soggybag/Loop-Echo/docs/small_time_reference.jpg

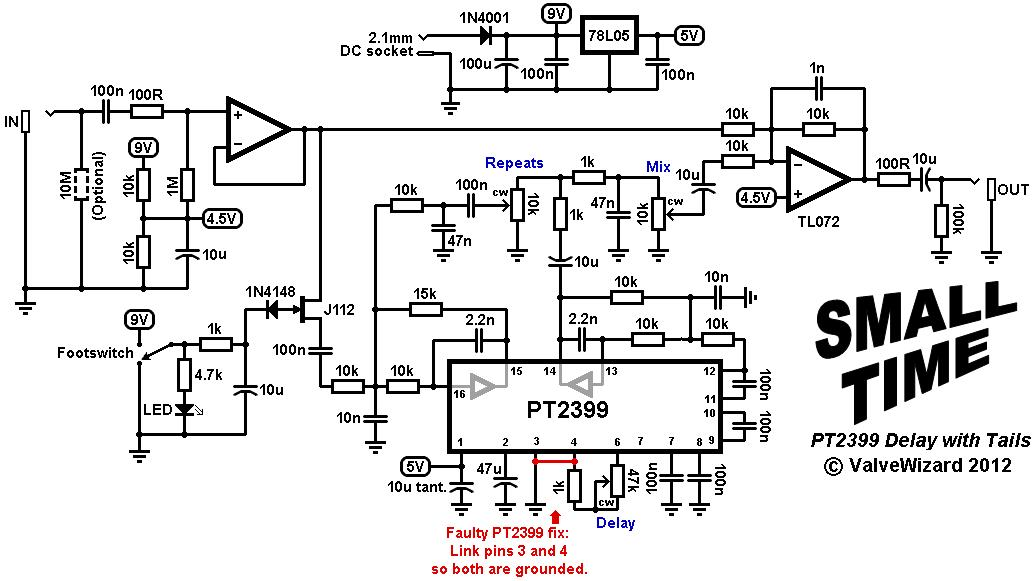
docs/small_time_reference.jpg
