soggybag/Loop-Echo/docs/LoopEcho_schematic.pdf

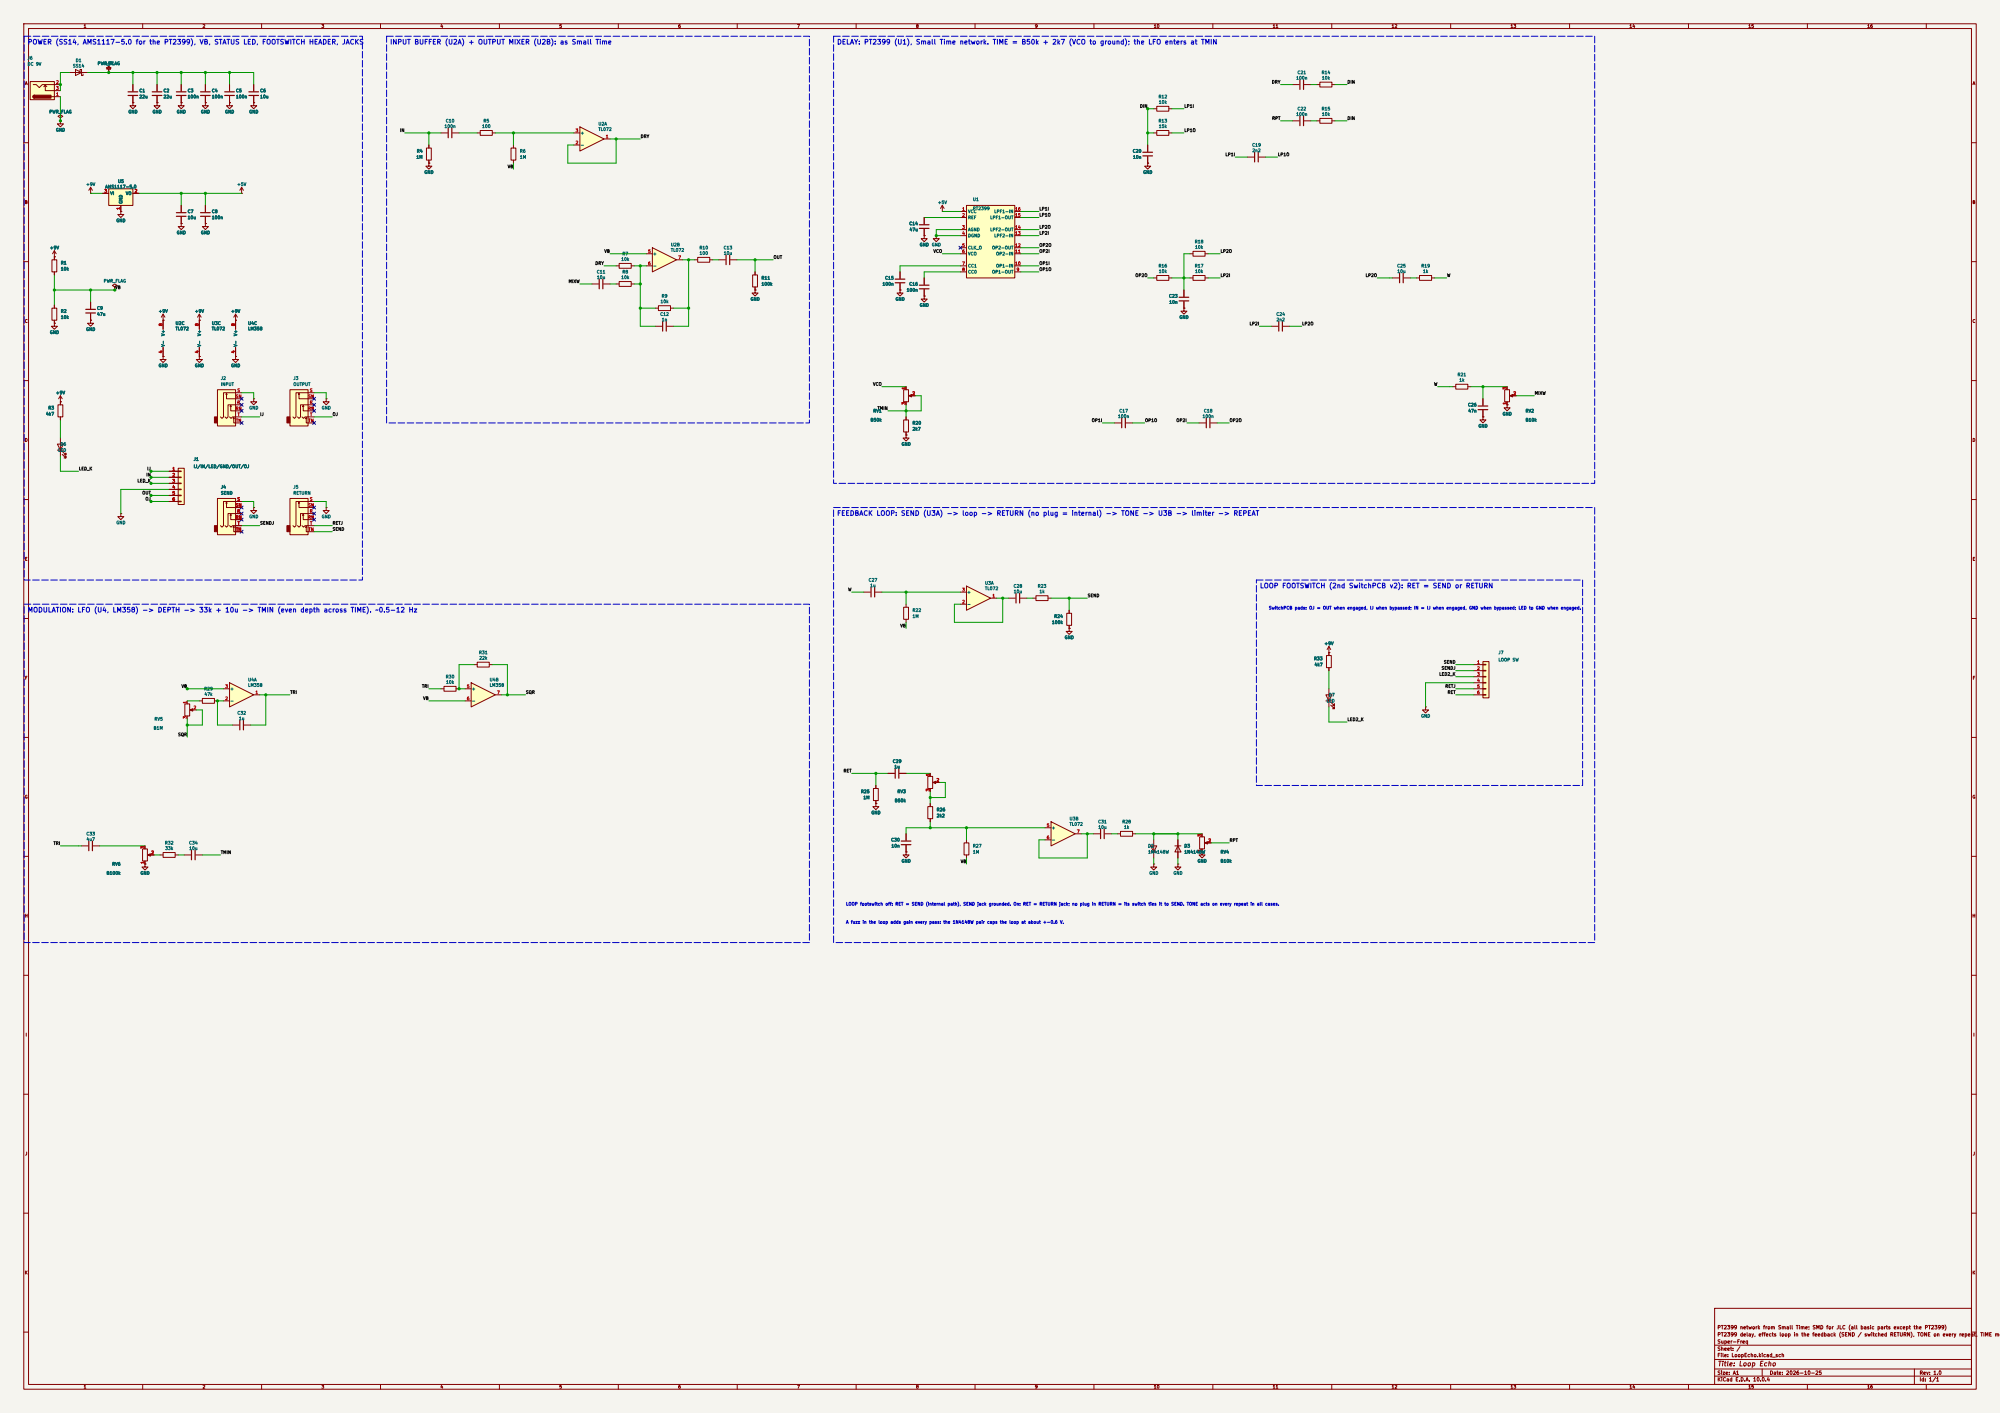
[picture p2: page 1]

POWER (SS14, AMS1117-5.0 for the PT2399), VB, STATUS LED, FOOTSWITCH HEADER, JACKS

IJ/IN/LED/GND/OUT/OJ

FEEDBACK LOOP: SEND (U3A) -> loop -> RETURN (no plug = internal) -> TONE -> U3B -> limiter -> REPEAT

LOOP FOOTSWITCH (2nd SwitchPCB v2): RET = SEND or RETURN

SwitchPCB pads: OJ = OUT when engaged, IJ when bypassed; IN = IJ when engaged, GND when bypassed; LED to GND when engaged.

A fuzz in the loop adds gain every pass: the 1N4148W pair caps the loop at about +-0.6 V. LOOP footswitch off: RET = SEND (internal path), SEND jack grounded. On: RET = RETURN jack; no plug in RETURN = its switch ties it to SEND. TONE acts on every repeat in all cases.

PT2399 network from Small Time; SMD for JLC (all basic parts except the PT2399)
PT2399 delay, effects loop in the feedback (SEND / switched RETURN), TONE on every repeat, TIME modulation
Super-Freq
Sheet: /
File: LoopEcho.kicad_sch
Title: Loop Echo

Size: A1 | Rev: 1.0
KiCad E.D.A. 10.0.4 | Id: 1/1
