soggybag/Loop-Echo/LoopEcho.kicad_pcb

## KiCad design LoopEcho.kicad_pcb (2026-10-27)

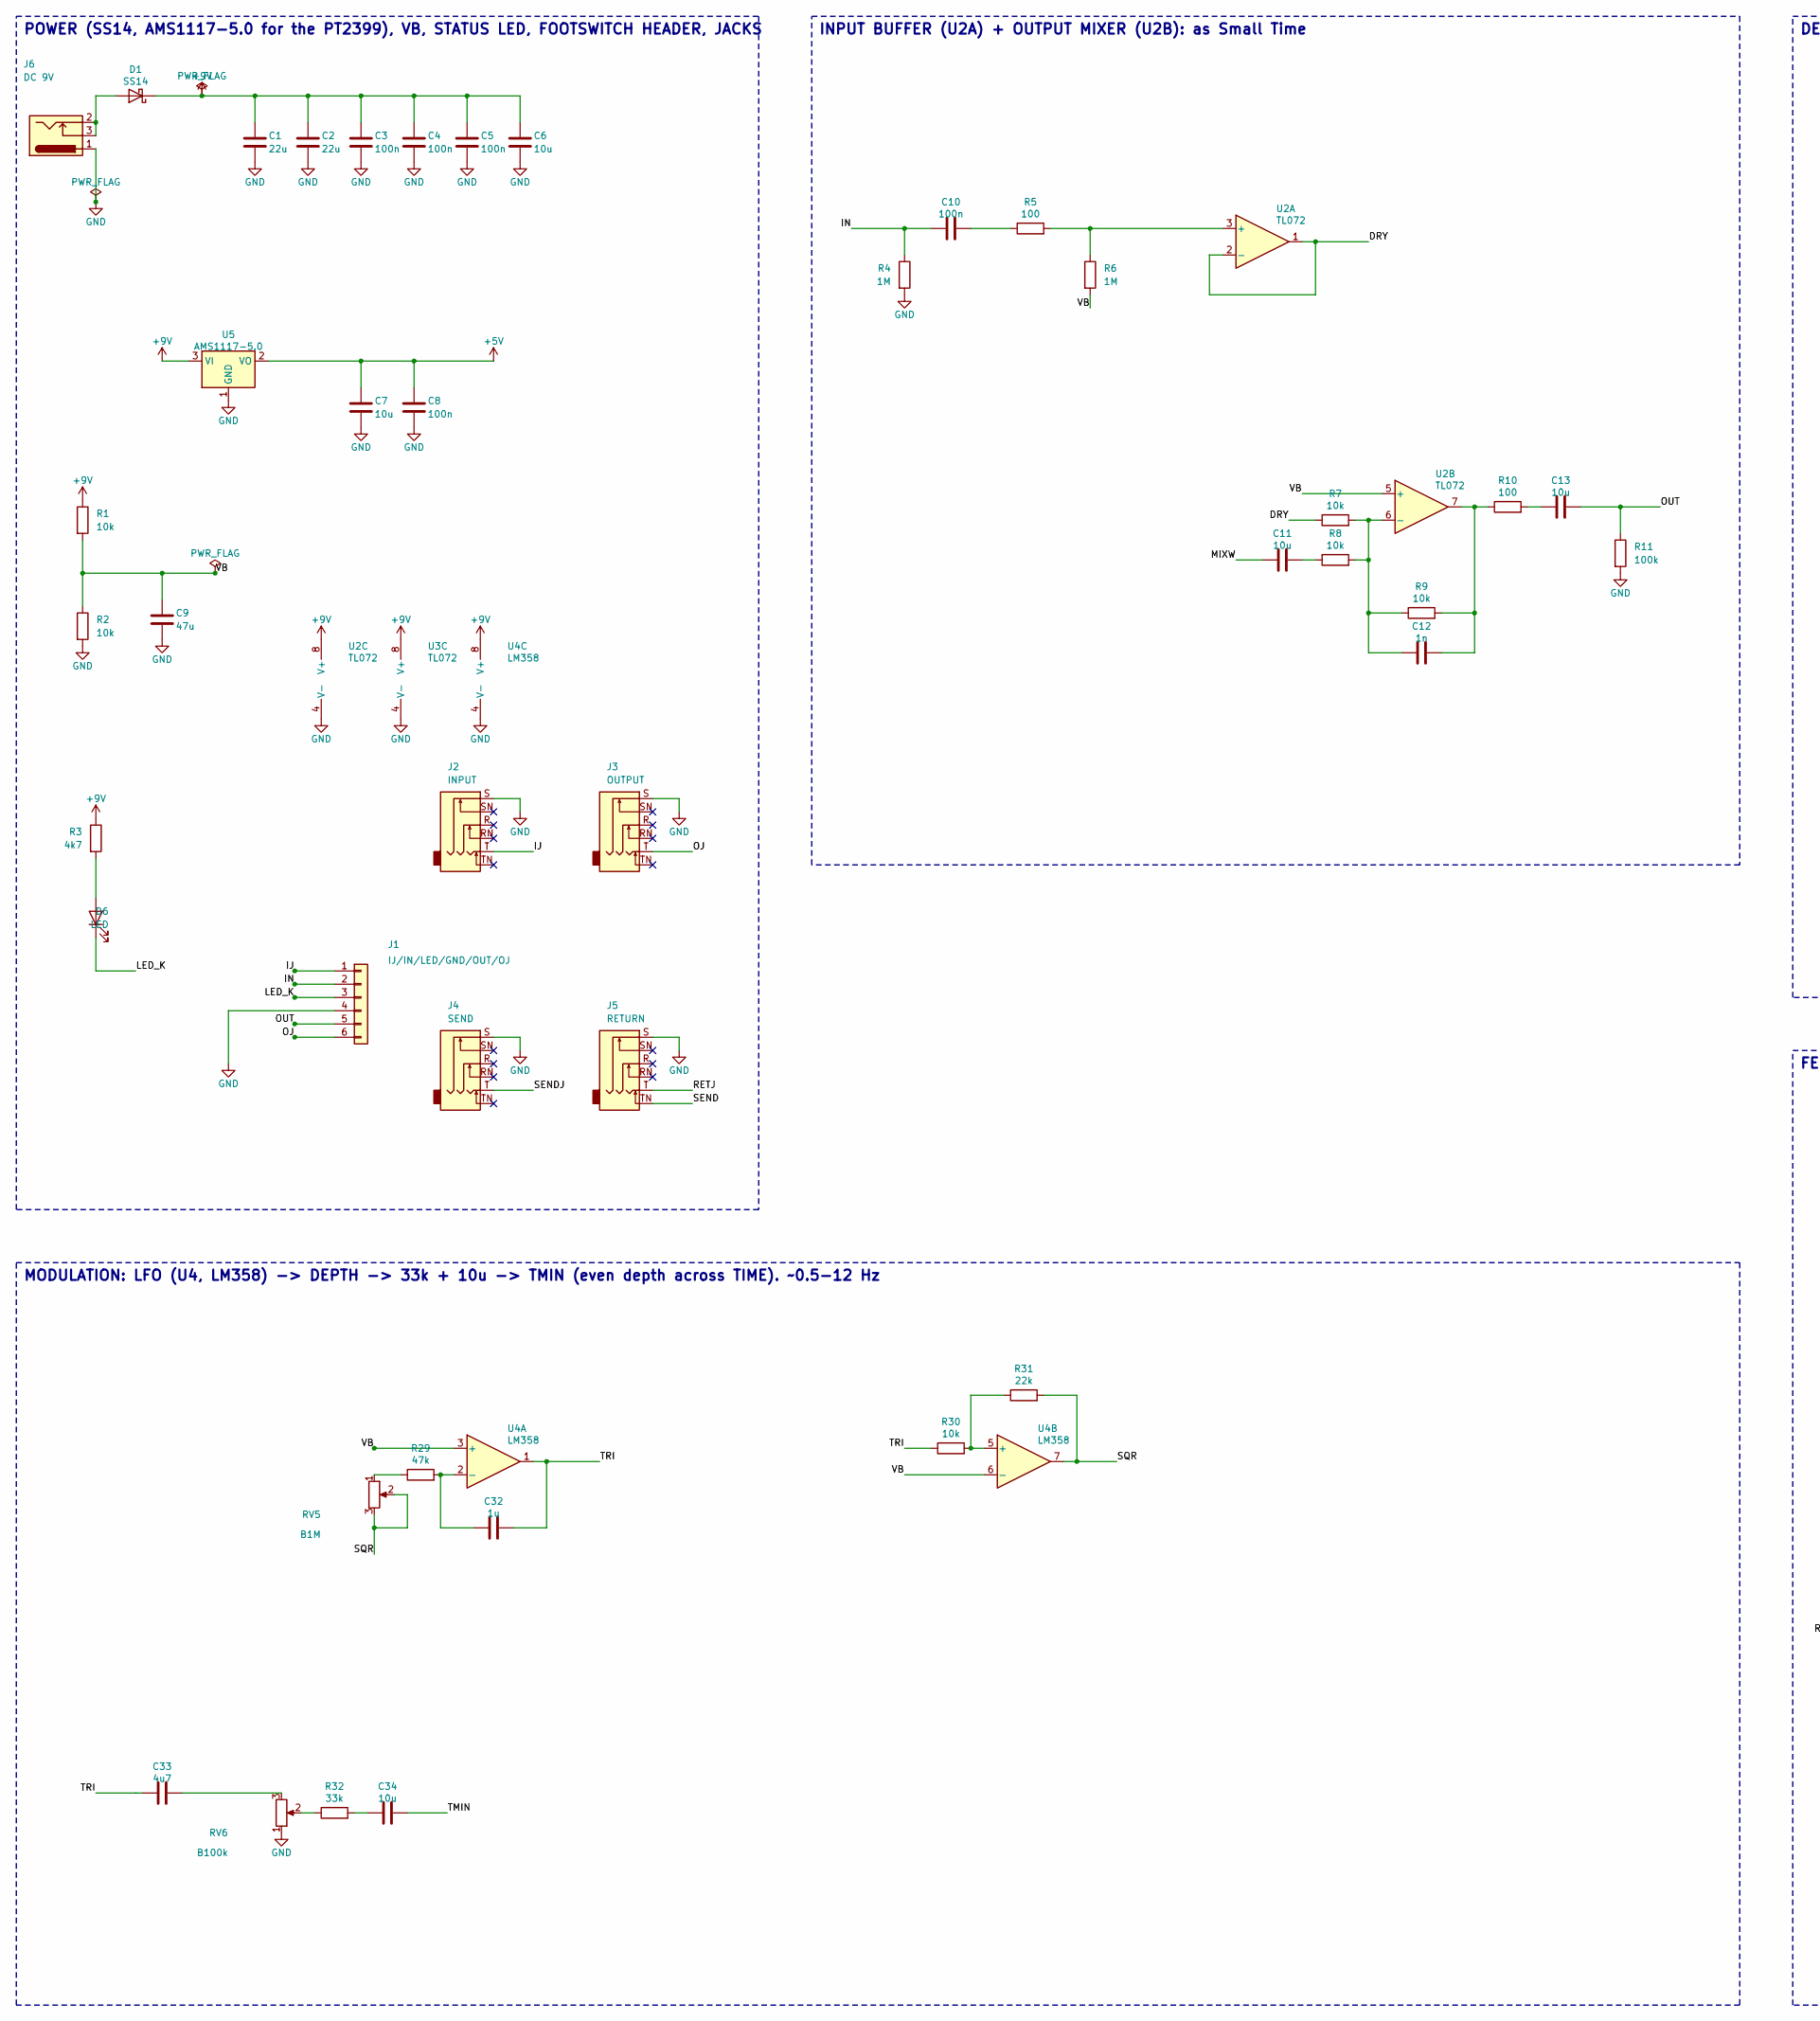
[picture p3: schematic LoopEcho.kicad_sch, Loop Echo, part in row 1, column 1]

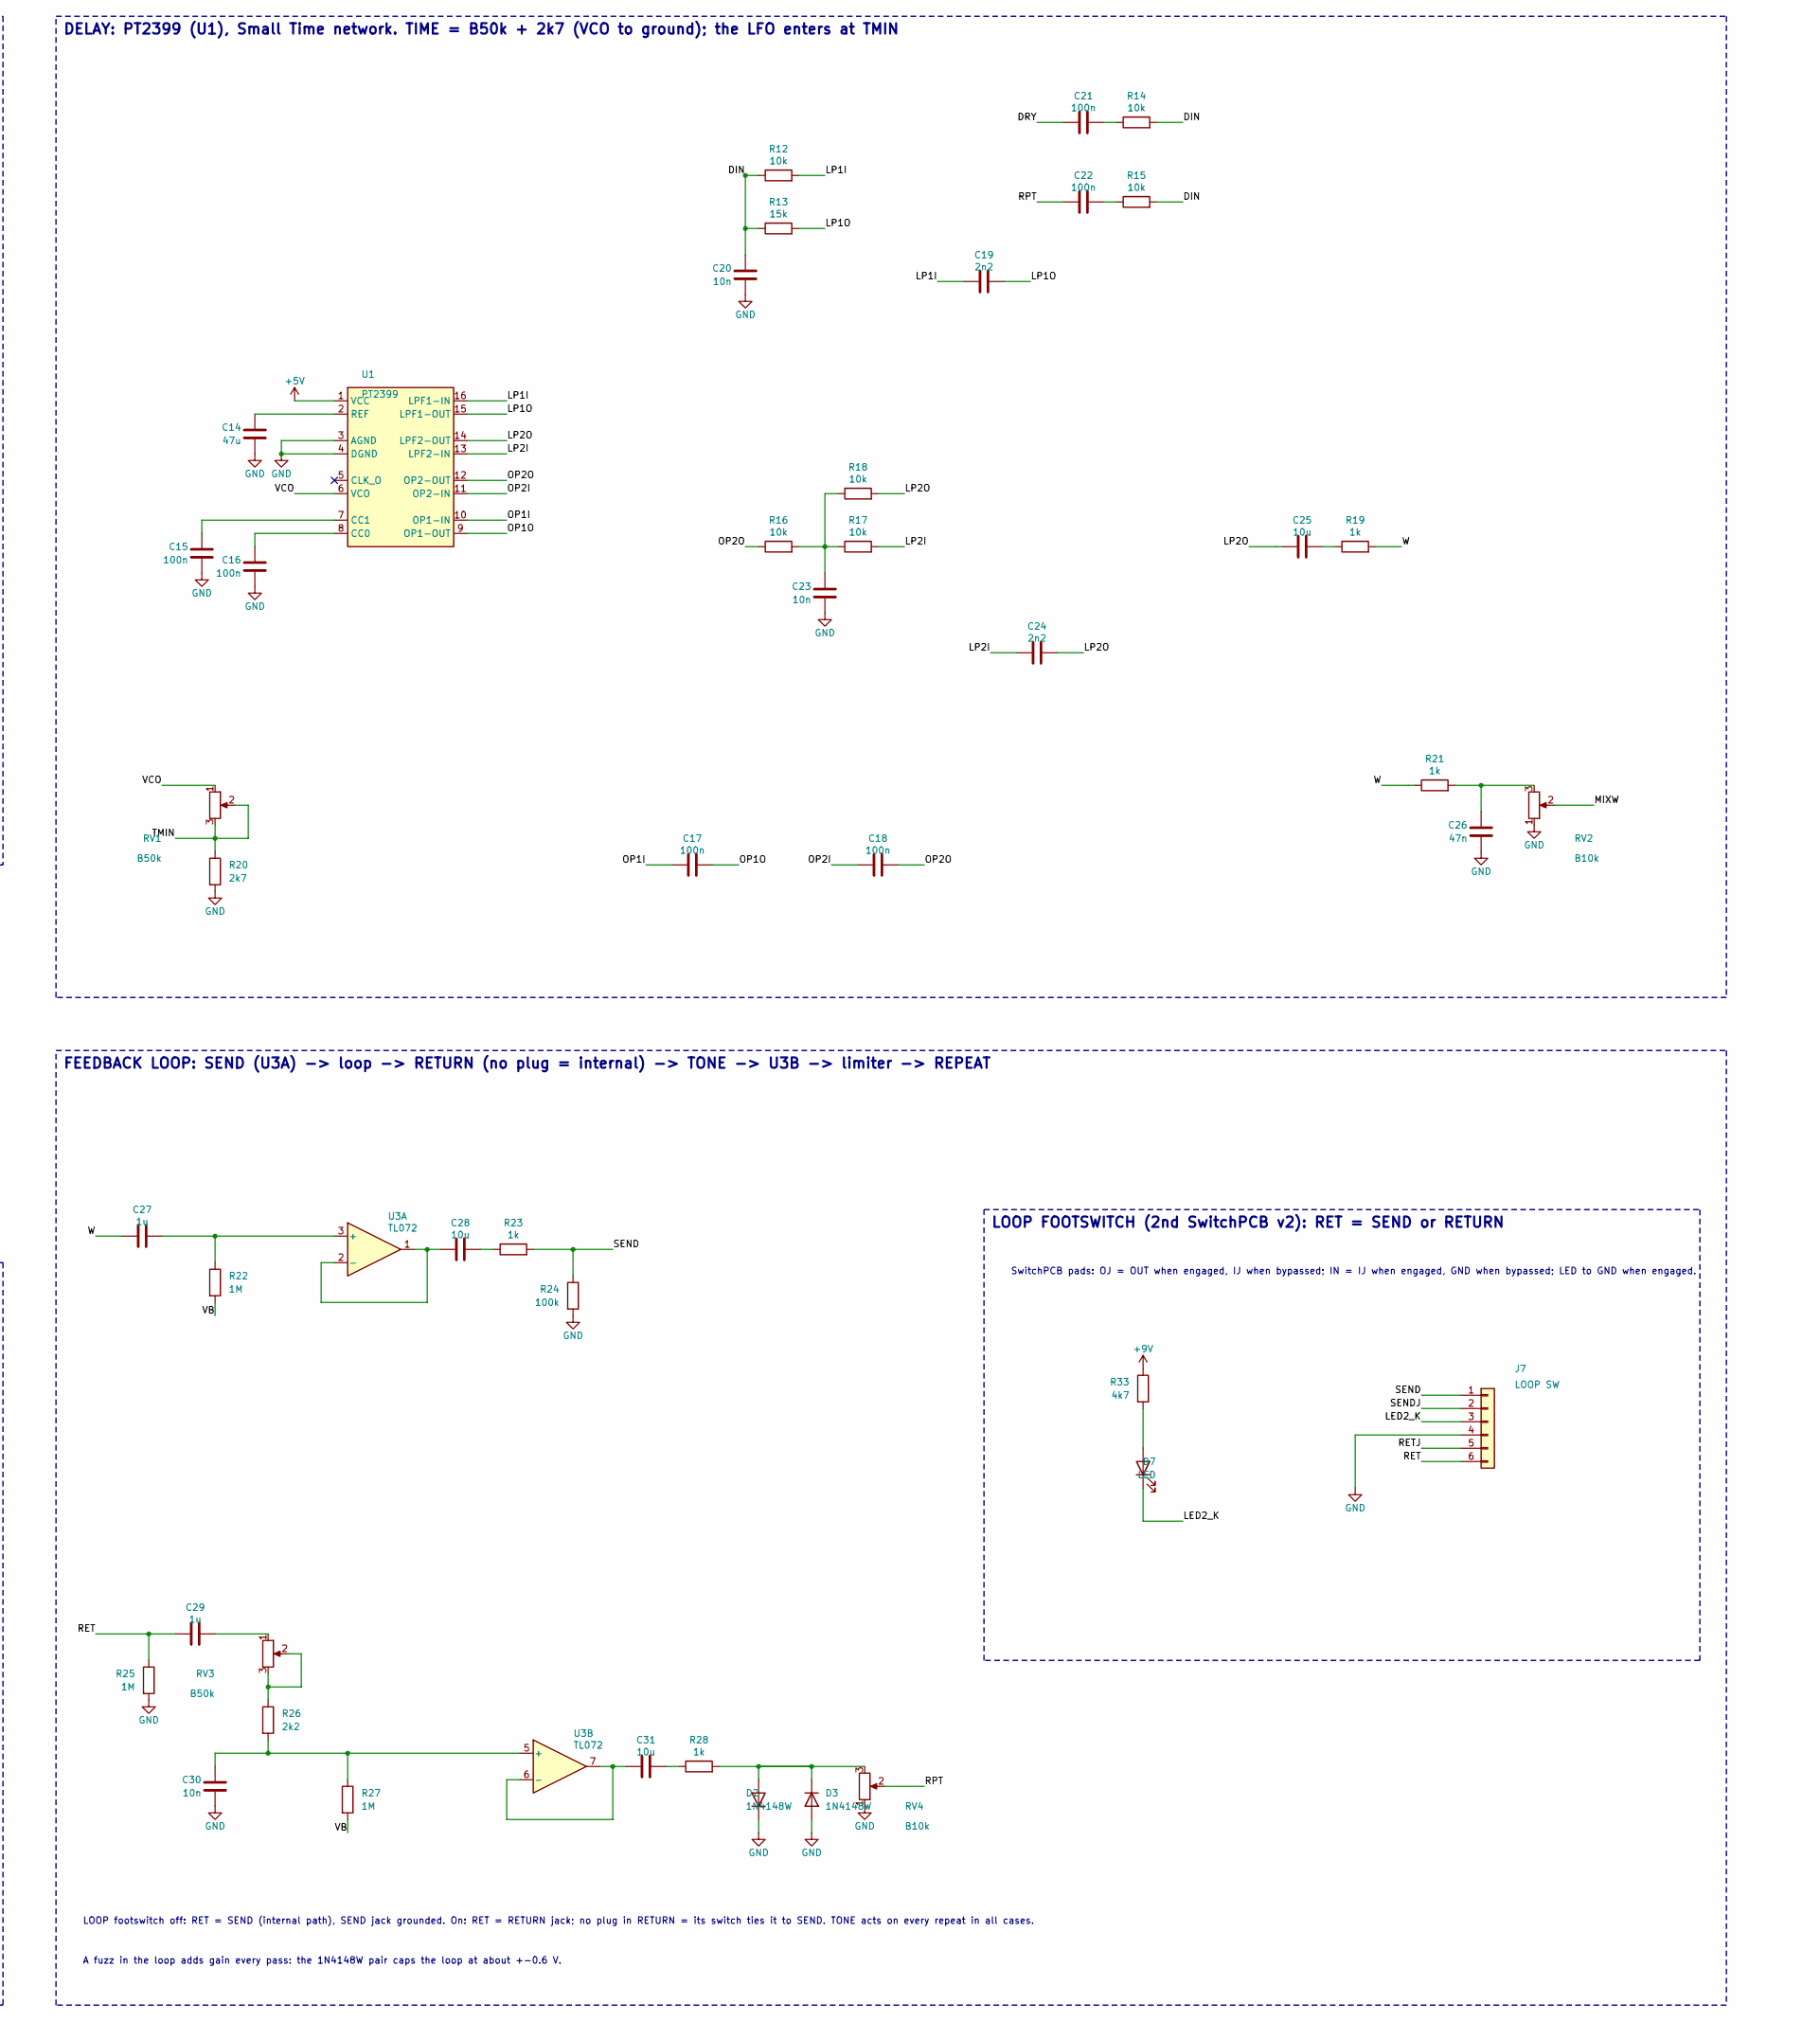
[picture p4: schematic LoopEcho.kicad_sch, Loop Echo, part in row 1, column 2]

Parts:
C1, C2: 22u; C_0805_2012Metric_Pad1.18x1.45mm_HandSolder; LCSC C45783
C3, C4, C5, C8, C10, C15, C16, C17, C18, C21, C22: 100n; C_0805_2012Metric_Pad1.18x1.45mm_HandSolder; LCSC C49678
C6, C7, C11, C13, C25, C28, C31, C34: 10u; C_0805_2012Metric_Pad1.18x1.45mm_HandSolder; LCSC C15850
C9, C14: 47u; C_1206_3216Metric_Pad1.33x1.80mm_HandSolder; LCSC C96123
C12: 1n; C_0805_2012Metric_Pad1.18x1.45mm_HandSolder; LCSC C46653
C19, C24: 2n2; C_0805_2012Metric_Pad1.18x1.45mm_HandSolder; LCSC C28260
C20, C23, C30: 10n; C_0805_2012Metric_Pad1.18x1.45mm_HandSolder; LCSC C1710
C26: 47n; C_0805_2012Metric_Pad1.18x1.45mm_HandSolder; LCSC C53134
C27, C29, C32: 1u; C_0805_2012Metric_Pad1.18x1.45mm_HandSolder; LCSC C28323
C33: 4u7; C_0805_2012Metric_Pad1.18x1.45mm_HandSolder; LCSC C1779
D1: SS14; D_SMA; LCSC C2480
D2, D3: 1N4148W; D_SOD-123; LCSC C81598
D6, D7: LED; LED_D3.0mm
J1: IJ/IN/LED/GND/OUT/OJ; PinHeader_1x06_P2.54mm_Vertical
J2: INPUT; Jack_6.35mm_PJ-646F_Horizontal
J3: OUTPUT; Jack_6.35mm_PJ-646F_Horizontal
J4: SEND; Jack_6.35mm_PJ-646F_Horizontal
J5: RETURN; Jack_6.35mm_PJ-646F_Horizontal
J6: DC 9V; DC_Jack_2.1mm_A-4118_Horizontal
J7: LOOP SW; PinHeader_1x06_P2.54mm_Vertical
R1, R2, R7, R8, R9, R12, R14, R15, R16, R17, R18, R30: 10k; R_0805_2012Metric_Pad1.20x1.40mm_HandSolder; LCSC C17414
R3, R33: 4k7; R_0805_2012Metric_Pad1.20x1.40mm_HandSolder; LCSC C17673
R4, R6, R22, R25, R27: 1M; R_0805_2012Metric_Pad1.20x1.40mm_HandSolder; LCSC C17514
R5, R10: 100; R_0805_2012Metric_Pad1.20x1.40mm_HandSolder; LCSC C17408
R11, R24: 100k; R_0805_2012Metric_Pad1.20x1.40mm_HandSolder; LCSC C149504
R13: 15k; R_0805_2012Metric_Pad1.20x1.40mm_HandSolder; LCSC C17475
R19, R21, R23, R28: 1k; R_0805_2012Metric_Pad1.20x1.40mm_HandSolder; LCSC C17513
R20: 2k7; R_0805_2012Metric_Pad1.20x1.40mm_HandSolder; LCSC C17530
R26: 2k2; R_0805_2012Metric_Pad1.20x1.40mm_HandSolder; LCSC C17520
R29: 47k; R_0805_2012Metric_Pad1.20x1.40mm_HandSolder; LCSC C17713
R31: 22k; R_0805_2012Metric_Pad1.20x1.40mm_HandSolder; LCSC C17560
R32: 33k; R_0805_2012Metric_Pad1.20x1.40mm_HandSolder; LCSC C17633
RV1, RV3: B50k; Potentiometer_Alpha_RD901F-40-00D_Single_Vertical
RV2, RV4: B10k; Potentiometer_Alpha_RD901F-40-00D_Single_Vertical
RV5: B1M; Potentiometer_Alpha_RD901F-40-00D_Single_Vertical
RV6: B100k; Potentiometer_Alpha_RD901F-40-00D_Single_Vertical
U1: PT2399; SOIC-16_3.9x9.9mm_P1.27mm; LCSC C126407
U2, U3: TL072; SOIC-8_3.9x4.9mm_P1.27mm; LCSC C6961
U4: LM358; SOIC-8_3.9x4.9mm_P1.27mm; LCSC C7950
U5: AMS1117-5.0; SOT-223-3_TabPin2; LCSC C6187

Connections:
+5V: C7.1, C8.1, U1.1 (VCC), U5.2 (VO)
/DIN: C20.1, R12.1, R13.1, R14.2, R15.2
/DRY: C21.1, R7.1, U2.1, U2.2 (-)
/IJ: J1.1, J2.T
/IN: C10.1, J1.2, R4.1
/LED2_K: D7.1 (K), J7.3
/LED_K: D6.1 (K), J1.3
/LP1I: C19.1, R12.2, U1.16 (LPF1-IN)
/LP1O: C19.2, R13.2, U1.15 (LPF1-OUT)
/LP2I: C24.1, R17.2, U1.13 (LPF2-IN)
/LP2O: C24.2, C25.1, R18.2, U1.14 (LPF2-OUT)
/MIXW: C11.1, RV2.2
/OJ: J1.6, J3.T
/OP1I: C17.1, U1.10 (OP1-IN)
/OP1O: C17.2, U1.9 (OP1-OUT)
/OP2I: C18.1, U1.11 (OP2-IN)
/OP2O: C18.2, R16.1, U1.12 (OP2-OUT)
/OUT: C13.2, J1.5, R11.1
/RET: C29.1, J7.6, R25.1
/RETJ: J5.T, J7.5
/RPT: C22.1, RV4.2
/SEND: J5.TN, J7.1, R23.2, R24.1
/SENDJ: J4.T, J7.2
/SQR: R31.2, RV5.2, RV5.3, U4.7
/TMIN: C34.2, R20.1, RV1.2, RV1.3
/TRI: C32.2, C33.1, R30.1, U4.1
/VCO: RV1.1, U1.6 (VCO)
/W: C27.1, R19.2, R21.1
unnamed: C10.2, R5.1
unnamed: C11.2, R8.1
unnamed: C12.2, R9.2, R10.1, U2.7
unnamed: C13.1, R10.2
unnamed: C21.2, R14.1
unnamed: C22.2, R15.1
unnamed: C23.1, R16.2, R17.1, R18.1
unnamed: C25.2, R19.1
unnamed: C26.1, R21.2, RV2.3
unnamed: C28.2, R23.1
unnamed: C29.2, RV3.1
unnamed: C31.2, R28.1
unnamed: C33.2, RV6.3
unnamed: C34.1, R32.2
unnamed: D1.2 (A), J6.2, J6.3
unnamed: D2.2 (A), D3.1 (K), R28.2, RV4.3
unnamed: D6.2 (A), R3.2
unnamed: D7.2 (A), R33.2
unnamed: R26.1, RV3.2, RV3.3
unnamed: R29.1, RV5.1
unnamed: R32.1, RV6.2
unnamed: C16.1, U1.8 (CC0)
unnamed: C15.1, U1.7 (CC1)
unnamed: C14.1, U1.2 (REF)
unnamed: R5.2, R6.1, U2.3 (+)
unnamed: C12.1, R7.2, R8.2, R9.1, U2.6 (-)
unnamed: C27.2, R22.1, U3.3 (+)
unnamed: C28.1, U3.1, U3.2 (-)
unnamed: C30.1, R26.2, R27.1, U3.5 (+)
unnamed: C31.1, U3.6 (-), U3.7
unnamed: C32.1, R29.2, U4.2 (-)
unnamed: R30.2, R31.1, U4.5 (+)

Notes on the sheet:
POWER (SS14, AMS1117-5.0 for the PT2399), VB, STATUS LED, FOOTSWITCH HEADER, JACKS
INPUT BUFFER (U2A) + OUTPUT MIXER (U2B): as Small Time
DELAY: PT2399 (U1), Small Time network. TIME = B50k + 2k7 (VCO to ground); the LFO enters at TMIN
FEEDBACK LOOP: SEND (U3A) -> loop -> RETURN (no plug = internal) -> TONE -> U3B -> limiter -> REPEAT
LOOP footswitch off: RET = SEND (internal path), SEND jack grounded. On: RET = RETURN jack; no plug in RETURN = its switch ties it to SEND. TONE acts on every repeat in all cases.
A fuzz in the loop adds gain every pass: the 1N4148W pair caps the loop at about +-0.6 V.
MODULATION: LFO (U4, LM358) -> DEPTH -> 33k + 10u -> TMIN (even depth across TIME). ~0.5-12 Hz
LOOP FOOTSWITCH (2nd SwitchPCB v2): RET = SEND or RETURN
SwitchPCB pads: OJ = OUT when engaged, IJ when bypassed; IN = IJ when engaged, GND when bypassed; LED to GND when engaged.

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
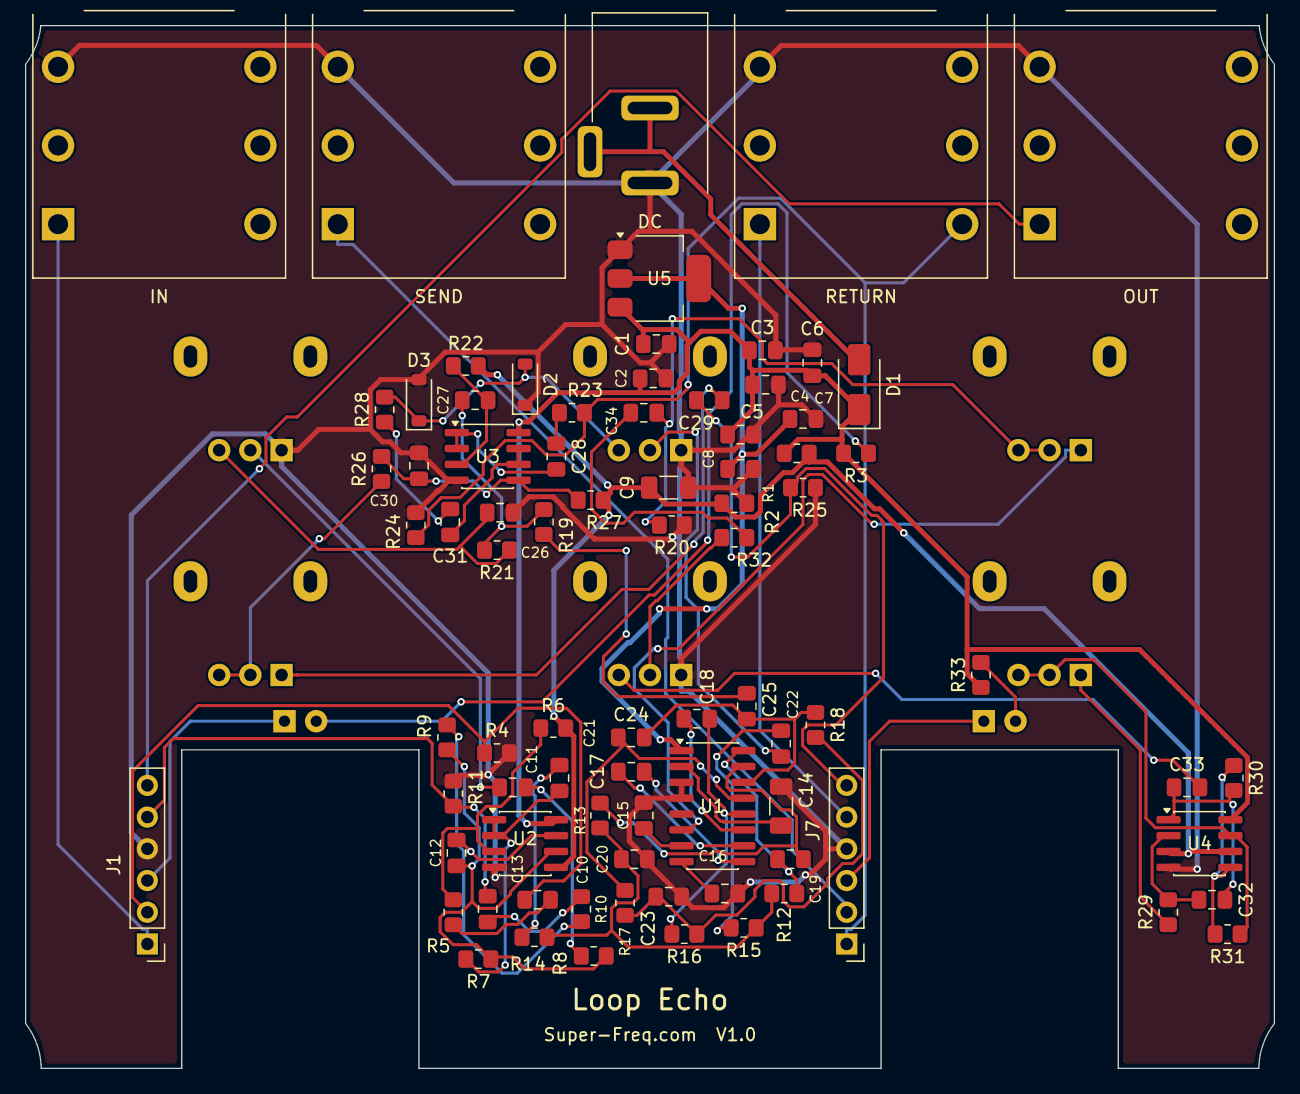
[picture p5: board LoopEcho.kicad_pcb from above]

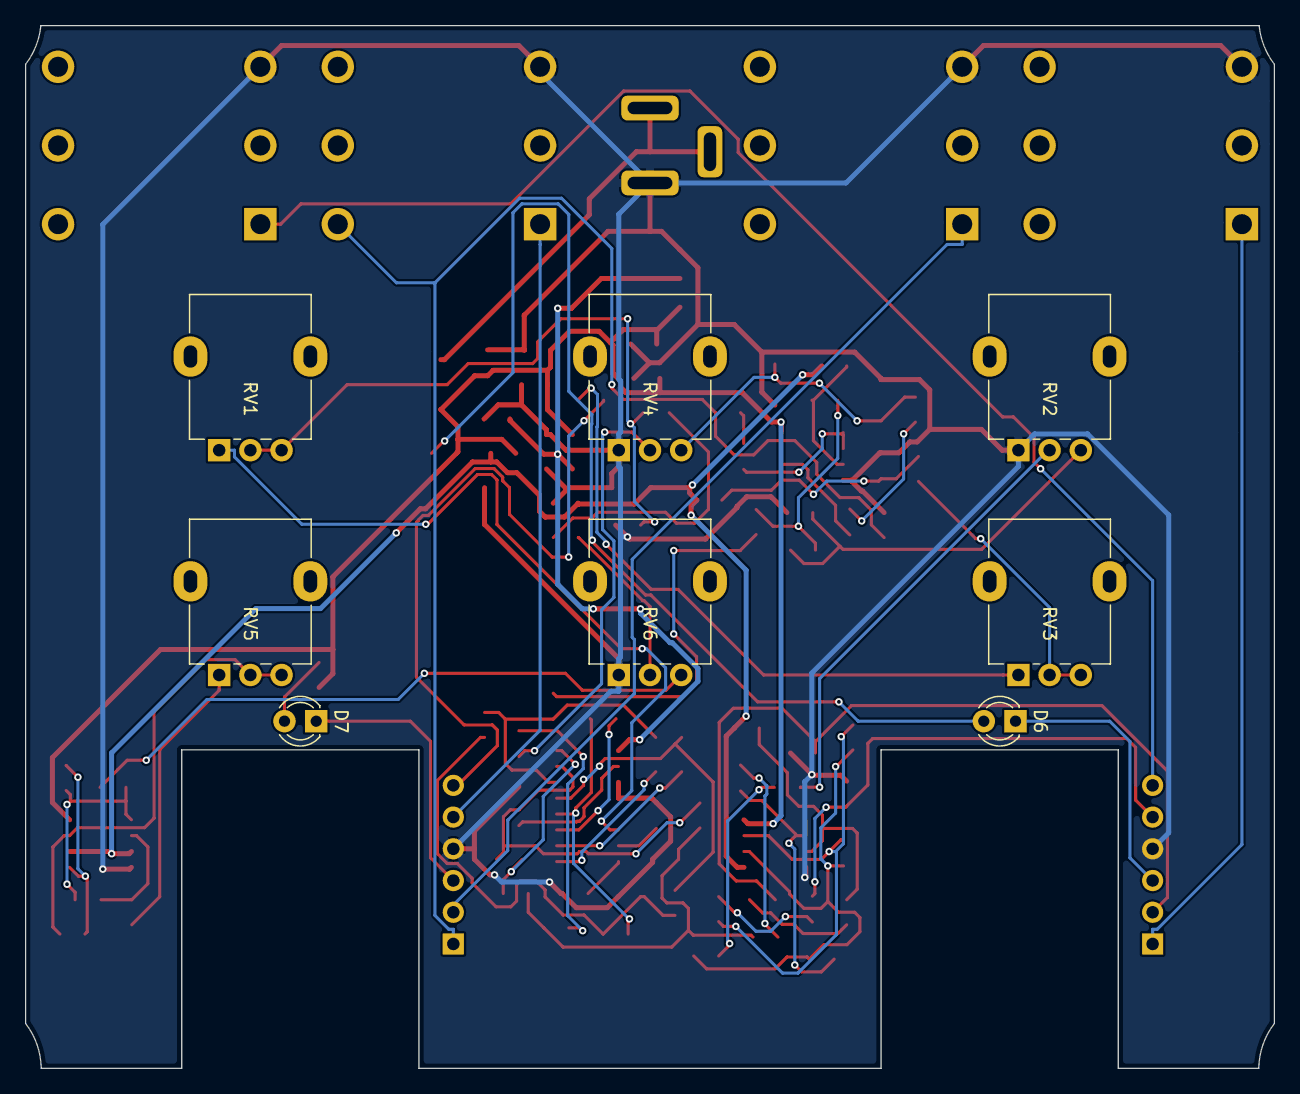
[picture p6: board LoopEcho.kicad_pcb from below]

Board: 2 copper layers, 100.0 x 83.5 mm, 90 parts (8 on the bottom side), 63 nets.
