soggybag/Loop-Echo/(commit log)

2026-10-17 Initial commit: KiCad project, docs and notes
    [LoopEcho.kicad_sch]
2026-10-25 Design notes: Dragonfish ideas (LFO into the TIME/R_min node, darker voicing option, low-power LFO op-amp)
2026-10-25 v1.0 SMD schematic: SEND / switched RETURN, TONE on every repeat, LFO into the TIME / 2k7 node, AMS1117, JLC parts; v0.1 generator kept
    [LoopEcho.kicad_sch]
2026-10-26 v1.0 board: 1590BB landscape, all five jacks on top (OUT RETURN DC SEND IN)
    - Schematic: board-mounted PJ-646F jacks (RETURN tip switch = SEND), A-4118 DC jack
    (centre negative, pads 2 + 3 to the SS14), 1x6 header in the SwitchPCB v2 order;
    wire pads removed. ERC 0.
    - Footprints from the Tayda drawings in SuperFreq.pretty.
    - Board: 100.0 x 83.5 mm, lid-boss cut-outs, footswitch notch, pots 2x3 + LED on the
    back, J1 vertical beside the notch (user). Routed: DRC 0 errors / 0 unconnected,
    parity clean, 63 vias. Board is hand-edited now: don't re-run buildpcb_loopecho.py.
    [LoopEcho.kicad_pcb, LoopEcho.kicad_sch]
2026-10-26 Two footswitches: LOOP (left) switches the effects loop, BYPASS (right)
    - Schematic: J7 header for a second SwitchPCB v2 wired as a loop selector
    (IJ = SEND, IN = SEND jack, LED = LOOP LED D7 / R33, OUT = RETURN jack, OJ = RET).
    Loop off: RET = SEND and the SEND jack is grounded. ERC 0.
    - Board (hand-edited, reworked in place): second notch, both headers beside their
    notches like the user's J1, LEDs at X +-28 / Y -14.2, U1 / U2 / U4 groups
    re-placed, re-routed: DRC 0 errors / 0 unconnected, parity clean, 47 vias.
    - buildpcb_loopecho.py marked out of date.
    [LoopEcho.kicad_pcb, LoopEcho.kicad_sch]
2026-10-26 Enclosure drilling files (1590BB landscape) and fab-file notes
    - scripts/make_enclosure.py reads every hole from the board: drill CSV (Tayda Box
    Tool), 1:1 template with the jack wall unfolded, Othermill face marks.
    - enclosure/README.md: face layout, jack-wall depths (estimates), fit checks.
    - README: production files (gitignored), JLC preview checks, silk pass still to do.
    [LoopEcho_1590BB_drill.csv]
2026-10-26 Re-route with the 0.4 mm Power net class restored
    Power class back in LoopEcho.kicad_pro (+9V, GND, +5V, /VB, D1-A; Default 0.25 mm; ERC and sch rev restored),
    board re-routed (placement kept, 88 vias, DRC 0/0, parity clean); buildpcb now restores the .kicad_pro at exit.
    [LoopEcho.kicad_pcb]
2026-10-27 Silk pass: references clear of pads and other silk
    Reference designators moved next to their parts (0.8-1.0 mm text), off pads, other silk and the board edge;
    copper unchanged, DRC 0 errors / 0 unconnected, parity clean. Fab files regenerated (production/, gitignored).
    [LoopEcho.kicad_pcb]
